Stapelzeiger/nanocopter/nanocopter-partlist.xlsx

Kategorie | Beschreibung | Name | QTY | Mouser | Preis | Digikey | Preis | Farnell | Preis
 |  |  |  |  | (CHF) |  | (EUR)
Stecker | Molex PicoBlade 8pin Sockel (rechtwinklig, smd) | 53261-0871 | 1 | 538-53261-0871 | 1.81 (ab 10)
 | Molex PicoBlade 8pin Stecker (für kabel) | 51021-0800 | 1 | 538-51021-0800 | 0.38 (ab 10)
 | Molex PicoBlade 4pin Sockel (rechtwinklig, smd) | 53261-0471 | 1 | 538-53261-0471 | 1.44 (ab 10)
 | Molex PicoBlade 4pin Stecker (für Kabel) | 51021-0400 | 1 | 538-51021-0400 | 0.38 (ab 10)
 | Molex PicoBlade pin crimps (100stk) | 50058-8000 | 1 | 538-50058-8000 | 7.9
 | Molex SlimStack 16pin (height 1.5mm) board-to-board receptacle | 54722-0164 | 1 | 538-54722-0164 | 1.96 (ab 10)
 | Molex SlimStack 16pin (height 1.5mm) board-to-board plug | 55560-0168 | 1 | 538-55560-0168 | 1.30 (ab 10)
 | micro usb AB | ZX62-AB-5PA(11) | 1 | 798-ZX62-AB-5PA11 | 1.14
Spezialteile | NTC 10k | NTCLE100E3103JB0 | 1 | 594-2381-640-63103 | 0.35
 | Fuse 3A | F0603HI3000V032T | 1 | 637-F0603HI3000V032 | 0.32
 | 15mOhm Shunt | WSLP0805R0150FEA | 1 | 71-WSLP0805R0150FEA | 0.81
 | push-button | PTS 525 | 1
Mosfets | Si1443EDH (load switch) | SI1443EDH-T1-GE3 | 1 | 78-SI1443EDH-T1-GE3 | 0.27
 | Si1958DH (Motor dual Mosfet) | SI1958DH-T1-E3 | 3 | 781-SI1958DH-T1-E3 | 0.7
Diodes | BAS3005B-02V (Motor Freilaufdiode) | BAS 3005B-02V H6327 | 6 | 726-BAS3005B02VH6327 | 0.21
 | MBR0520 (SEPIC, ChargePump out) | MBR0520LT1G | 2 | 863-MBR0520LT1G | 0.35
Capacitors
Sepic | C_OUT 10uF Low ESR (1206) | JMK316BJ106ML-T | 1 | 963-JMK316BJ106ML-T | 0.46
 | C_IN 2.2uF & STM32 Cap reg 2.2uF low ESR | JMK107BJ225KA-T | 3 | 963-JMK107BJ225KA-T | 0.24
 | C_SW 1uF Low ESR | TMK107BJ105KA-T | 1 | 963-TMK107BJ105KA-T | 0.17
 | DCDC C_OUT & STM32 Bypass & HMC5883L 4.7uF Low ESR | JMK107BJ475MA-T | 3 | 963-JMK107BJ475MA-T | 0.27
 | MPU6050 0603 50V 2.2nF | C1608X7R1H222K | 1 | 810-C1608X7R1H222KEP | 0.09
 | 4.7pF 250V f. USB-Shield | VJ0603D4R7CXPAJ | 1 | 77-VJ0603D4R7CXPAJ | 0.33
Inductors | Sepic: 10uH Vishay (alternative) | IFSC1111AZER100M01 | 2 | 70-IFSC1111AZER100M0 | 0.53
 | Sepic: 10uH Murata | LQH32CN100K33L | 2 | 81-LQH32CN100K33L | 0.29
 | Sepic: 10uH Taiyo Yuden (alternative 2) (KLEIN!) | CBC2518T100K | 2 | 963-CBC2518T100K | 0.17
Ferrite | BLM18KG331SN1D | BLM18KG331SN1D | 1 | BLM18KG331SN1D | 0.34
Widerstände | Spannungsteiler Sepic: 110k 1% | CR0603-FX-1103GLF | 1
 | Spannungsteiler Sepic: 180k 1% | CR0603-FX-1803ELF | 1
Ics | strom/spannuns messer | INA220AIDGST | 1 |  | 2.64
 | lipo lader | BQ24092DGQT | 1 |  | 1.06
 | eeprom | M24C32-WDW6TP | 1 |  | 0.67
 | lqfp64 | STM32F405RGT6 | 1 |  | 11.7
 | Push button ctrl | LTC2955ITS8-2#TRMPBF | 1 |  |  |  | 5.23
 | DCDC Charge pump | LTC3240EDC-3.3#TRMPBF | 1 |  |  |  | 3.34
 | SEPIC | LT1930ES5#TRMPBF | 1 |  |  |  | 4.27
