Stapelzeiger/nanocopter/nanocopter.pdf

# Sensors

# Connectors

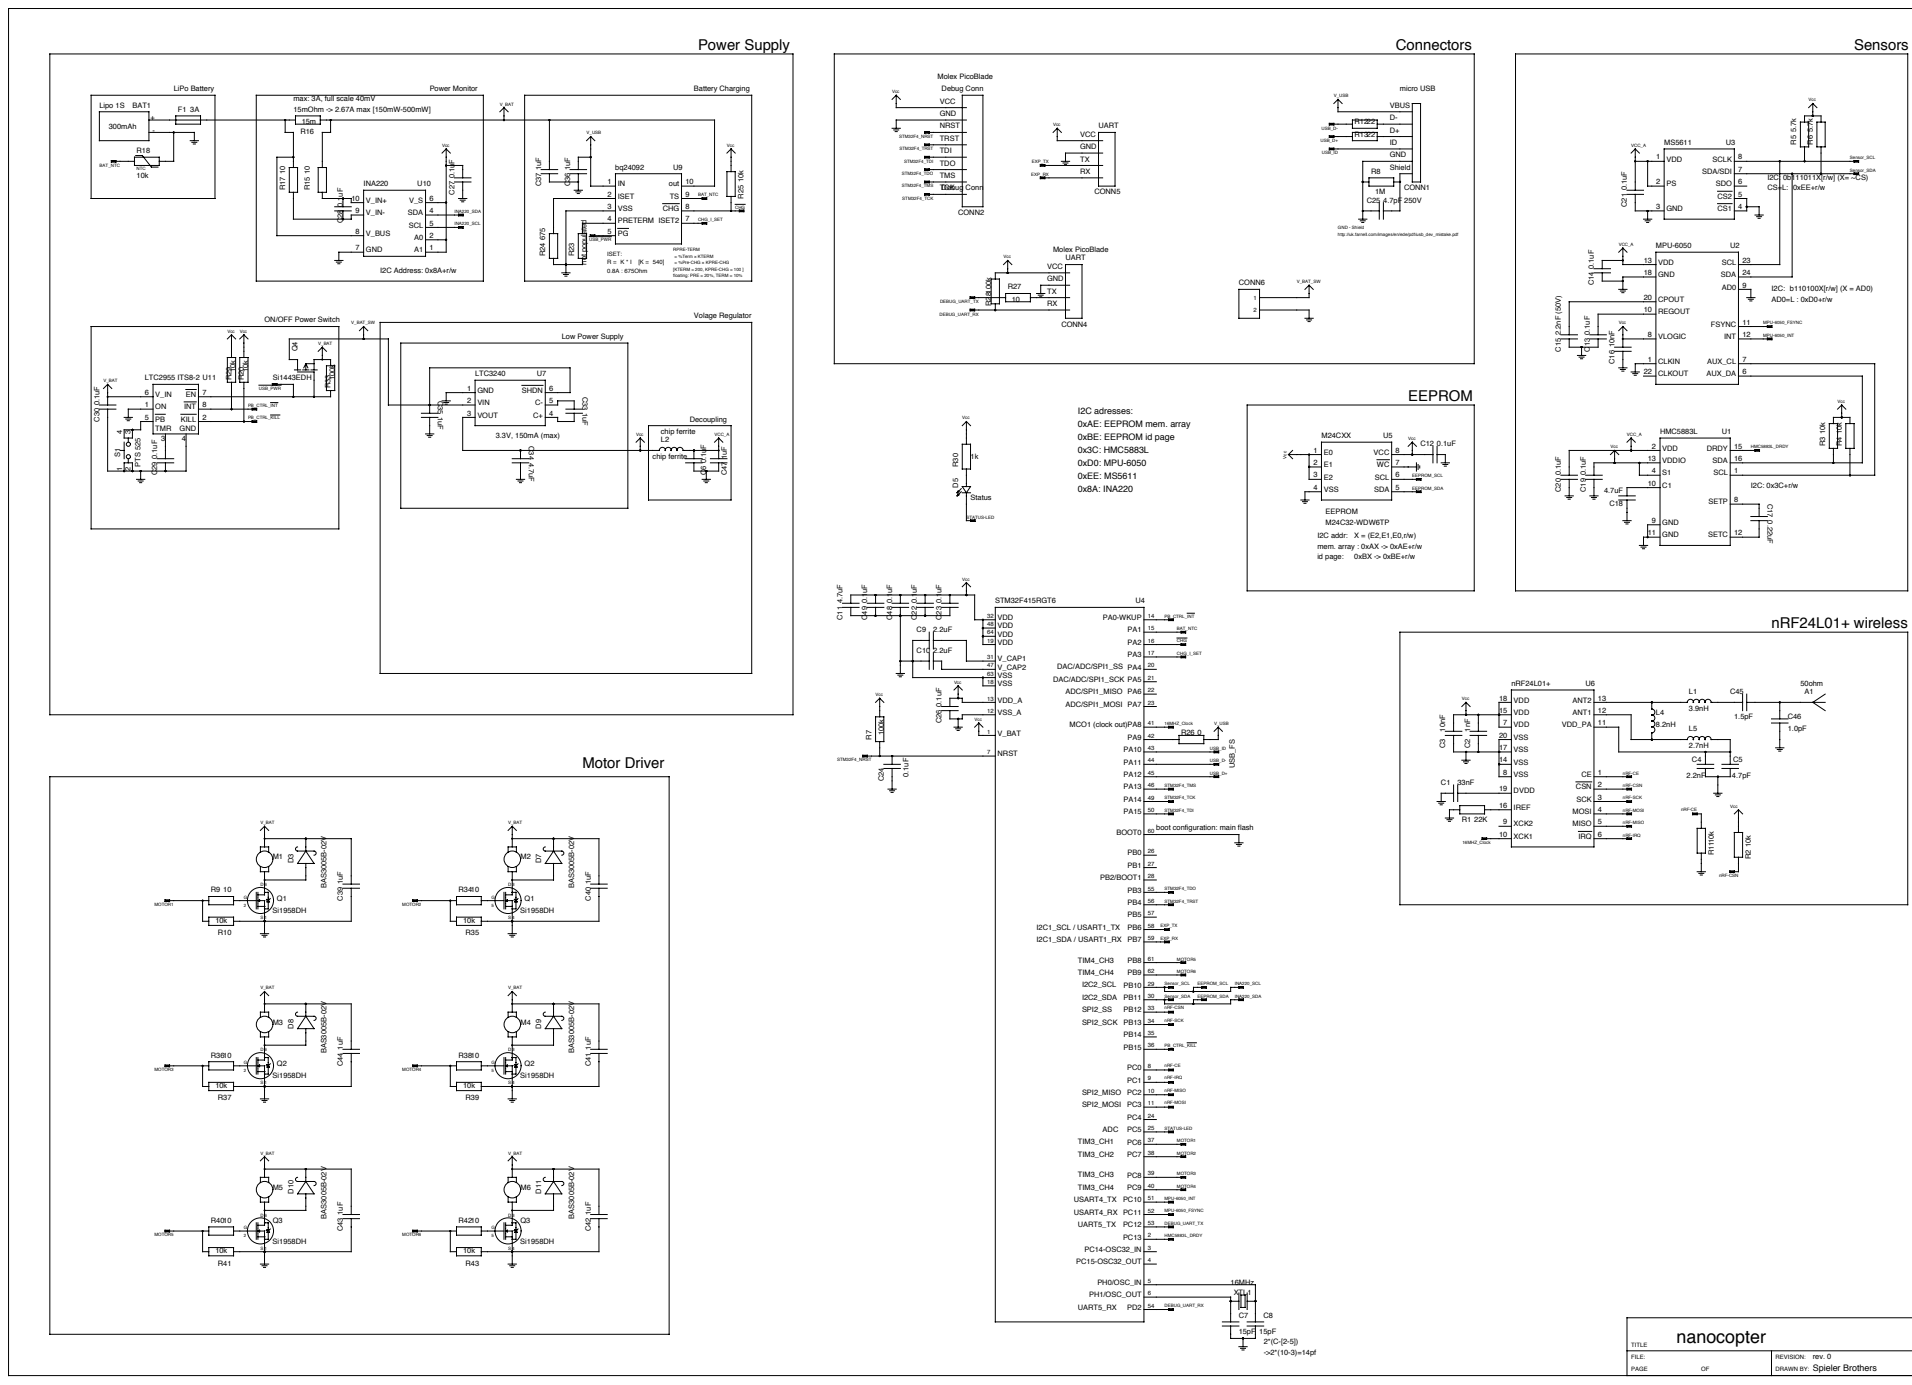
[picture p1: page 1]

GND - Shield
http://uk.farnell.com/images/en/ede/pdf/usb_dev_mistake.pdf

RPRE-TERM
= %Term × KTERM
= %Pre-CHG × KPRE-CHG
[KTERM = 200, KPRE-CHG = 100 ]
floating: PRE = 20%, TERM = 10%

boot configuration: main flash
