Stapelzeiger/nanocopter/(list of files, drawings)

Other design files:
nanocopter.pcb
