Stapelzeiger/nanocopter/(commit log)

2012-10-01 Added components to schematic
    - sensors
    - nRF
    - EEPROM
    - STM32F4
    - USB
    [nanocopter.sch]
2012-10-01 added debug connector
    (local symbol)
    [nanocopter.sch]
2012-10-01 added lipo
    [nanocopter.sch]
2012-10-01 nanocopter.sch signal routing
    [nanocopter.sch]
2012-10-04 update block diagramm with new, dual power supply
    [nanocopter-block-diagram.sch]
2012-10-07 added most of the power supply components
    [nanocopter.sch]
2012-10-08 updated power supply
    [nanocopter.sch]
2012-10-08 Added expansion connector
    [nanocopter.sch]
2012-10-08 started partlist
    [nanocopter-partlist.xlsx]
2012-10-08 Added missing sepic diode
    [nanocopter.sch]
2012-10-12 finished schematic
    all components on schematic & connected
    TODO:
    - add value & exact type of components
    - add footprints
    [nanocopter.sch]
2012-10-17 added more part-names of symbols
    [nanocopter-partlist.xlsx, nanocopter.sch]
2012-10-17 replaced balun in nRF circuit, removed refdes component numbers
    [nanocopter.sch]
2012-10-17 added footprint name to LTC2955
    [nanocopter.sch]
2012-10-17 added UART connector footprint name
    [nanocopter.sch]
2012-10-17 added debug connector footprint name
    [nanocopter.sch]
2012-10-18 all parts & values defined
    Todo: footprints
    [nanocopter-partlist.xlsx, nanocopter.sch]
2012-10-23 added all refdes and most resistor/capacitor footprints
    [nanocopter-partlist.xlsx, nanocopter.sch]
2012-10-23 updated capacitors
    [nanocopter-partlist.xlsx, nanocopter.sch]
2012-10-23 more footprints, removed redundant model attribute of motor diode
    [nanocopter.sch]
2012-10-29 added mosfet footprint
    [nanocopter.sch]
2012-10-29 added new button-symbol with footprint
    [nanocopter.sch]
2012-10-30 added possible usb-connector to partlist
    [nanocopter-partlist.xlsx]
2012-10-30 added footprint of lipo-charger
    [nanocopter.sch]
2012-10-30 updated schottky diode by symbol with correct pin numbering, added symbol
    [nanocopter.sch]
2012-10-31 more footprints
    [nanocopter.sch]
2012-10-31 moved schottky diode to library
2012-10-31 added footprint names
    [nanocopter.sch]
2012-10-31 corrected pinlabel error in connector symbols
2012-10-31 created nanocopter pcb file
    some footprints are still missing
    [nanocopter.pcb]
2012-10-31 added footprints
    [nanocopter.sch]
2012-11-01 corrected lipo-symbol pins & removed orphaned symbol labels in schematic
    [nanocopter.sch]
2012-11-01 corrected multislot mosfets in schematic, sorted/rearranged pcb components
    [nanocopter.pcb, nanocopter.sch]
2012-11-02 sorted components
    (micro usb shield is now connected in netlist)
    [nanocopter.pcb]
2012-11-02 updated footprints, arranged footprints
    arranged most of the footprints to the chips which they belong to
    moved nRF chip and sensors to backside
    [nanocopter.pcb, nanocopter.sch]
2012-11-02 organizing footpints
    [nanocopter.pcb]
2012-11-02 corrected LED and capacitor footprints
    [nanocopter.pcb, nanocopter.sch]
2012-11-03 added more bypassing capacitors for stm32
    [nanocopter.pcb, nanocopter.sch]
2012-11-03 added exported (pdf) schematic
2012-11-04 set overall layout
    placed connectors, nRF- and motor-cirquit, corrected VBat net, set trace style and DRC rules
    [nanocopter.pcb, nanocopter.sch]
2012-11-05 signal routing
    [nanocopter.pcb]
2012-11-08 changed layout of motor drivers
    [nanocopter.pcb]
2012-11-11 updated schematic, routing
    [nanocopter.pcb, nanocopter.sch]
2012-11-11 routing, smaller via hole
    [nanocopter.pcb]
2012-11-12 connected vdd_a of stm to vcc instead of vcc_a to simplify routing
    [nanocopter.pcb, nanocopter.sch]
2012-11-12 passes DRC
    [nanocopter.pcb]
2012-11-17 added status led & battery power connector
    [nanocopter.pcb, nanocopter.sch]
2012-11-17 new outline in silkscreen, changed GND layer
    [nanocopter.pcb]
2012-11-17 GND area changes
    [nanocopter.pcb]
2012-11-17 updated partlist
    [nanocopter-partlist.xlsx]
2012-11-18 resized pcb area to 5x5cm
    [nanocopter.pcb]
2012-12-09 added PCB gerber files
    files of fabricated PCB from 17.11.12
2012-12-09 corrected capacitor values
    [nanocopter.sch]
2013-01-03 updated exported pdf schematic
